hubbellc/Speaker/Speaker Assembly.jpg

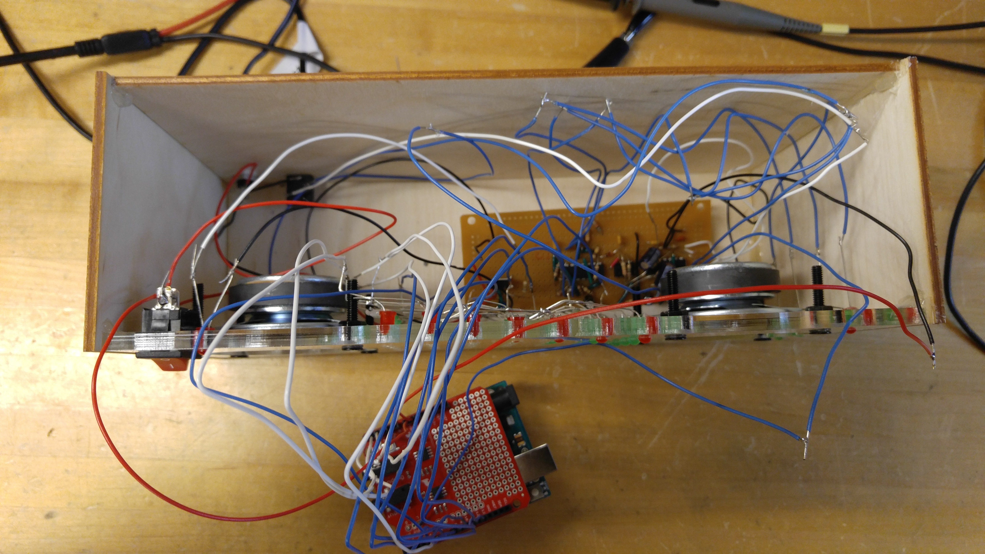
Speaker Assembly.jpg
