hubbellc/Speaker/Speaker Design Files/Speaker Box.SLDASM

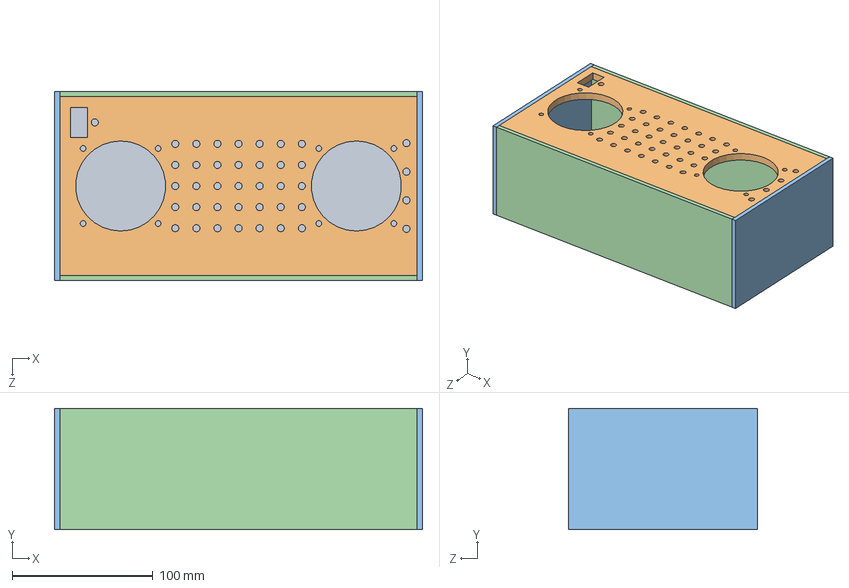
[picture p5: CAD file, 2018-04-09]
Speaker Design Files/Speaker Box.SLDASM
261.6 x 86.4 x 134.6 mm
Back plate
Side x 2
Top x 2
