hubbellc/Speaker/Speaker Design Files/DXF's/Front plate.SLDPRT.DXF

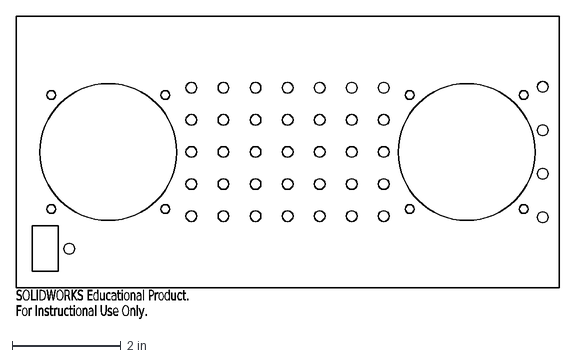
[picture p6: CAD file, 2018-04-09]
Speaker Design Files/DXF's/Front plate.SLDPRT.DXF
SOLIDWORKS Educational Product.
For Instructional Use Only.
