hubbellc/Speaker/Speaker Design Files/Top.SLDPRT

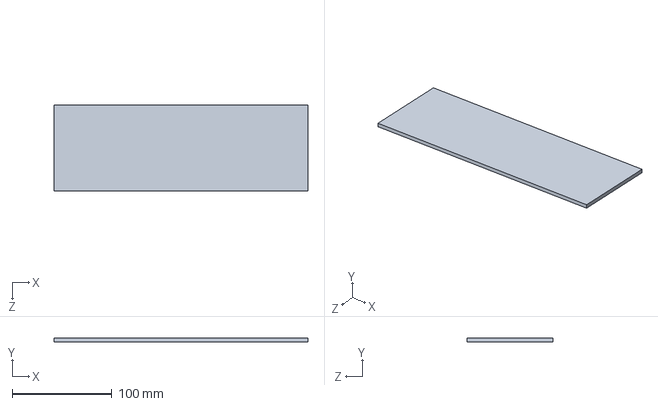
[picture p7: CAD file, 2018-04-09]
Speaker Design Files/Top.SLDPRT
254.0 x 3.81 x 86.4 mm
