hubbellc/Speaker/Speaker Design Files/Back plate.SLDPRT

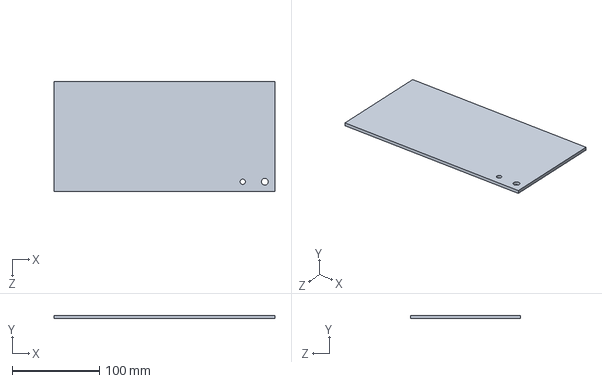
[picture p8: CAD file, 2018-04-09]
Speaker Design Files/Back plate.SLDPRT
254.0 x 3.81 x 127.0 mm
