hubbellc/Speaker/Speaker Design Files/DXF's/Back plate.DXF

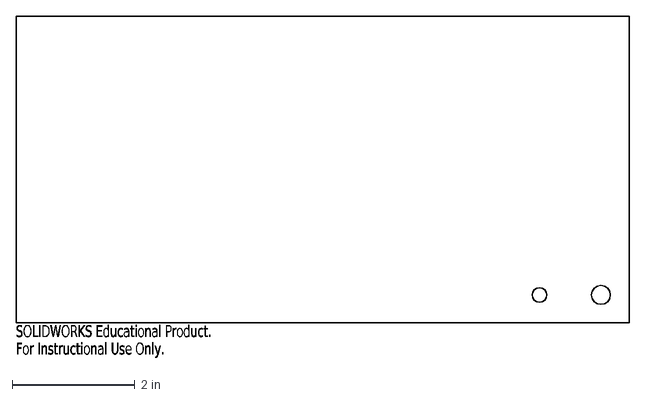
[picture p9: CAD file, 2018-04-09]
Speaker Design Files/DXF's/Back plate.DXF
SOLIDWORKS Educational Product.
For Instructional Use Only.
