hubbellc/Speaker/Speaker Design Files/DXF's/Side.DXF

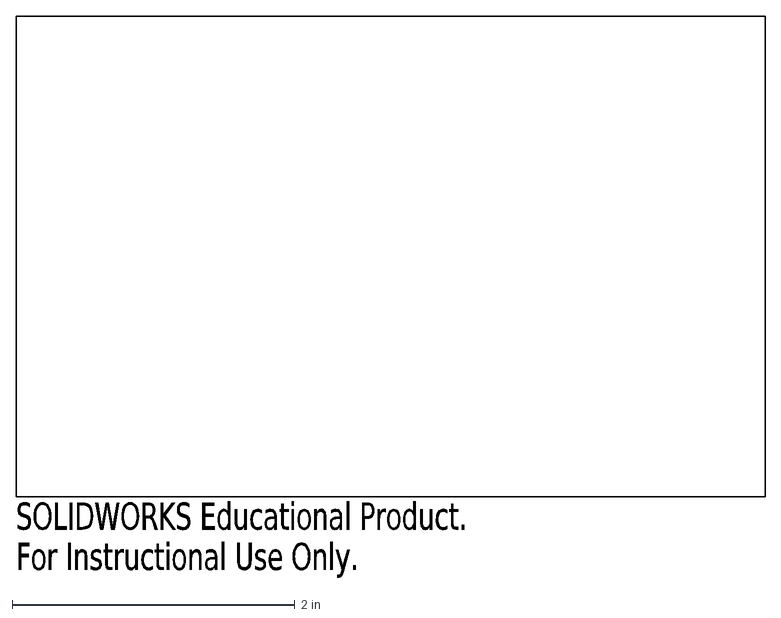
[picture p10: CAD file, 2018-04-09]
Speaker Design Files/DXF's/Side.DXF
SOLIDWORKS Educational Product.
For Instructional Use Only.
