hubbellc/Speaker/Speaker Design Files/DXF's/Top.DXF

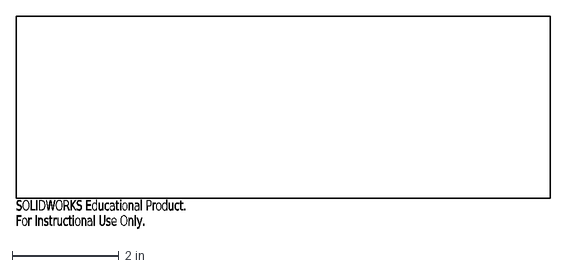
[picture p11: CAD file, 2018-04-09]
Speaker Design Files/DXF's/Top.DXF
SOLIDWORKS Educational Product.
For Instructional Use Only.
