hubbellc/Speaker/Speaker Design Files/Side.SLDPRT

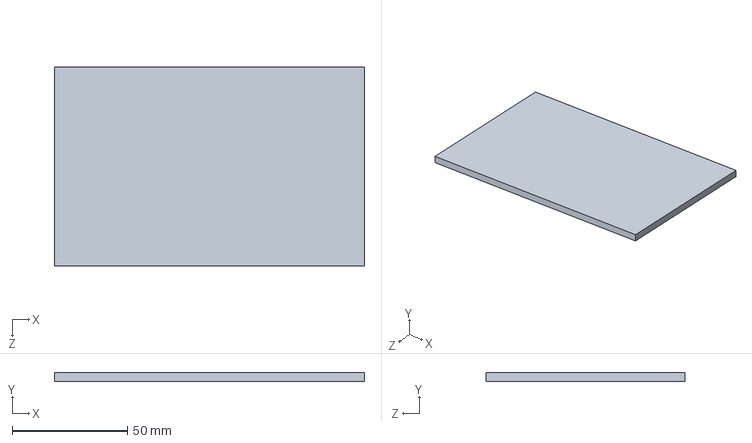
[picture p12: CAD file, 2018-04-09]
Speaker Design Files/Side.SLDPRT
134.6 x 3.81 x 86.4 mm
