hubbellc/Speaker/Speaker Design Files/Front plate.SLDPRT

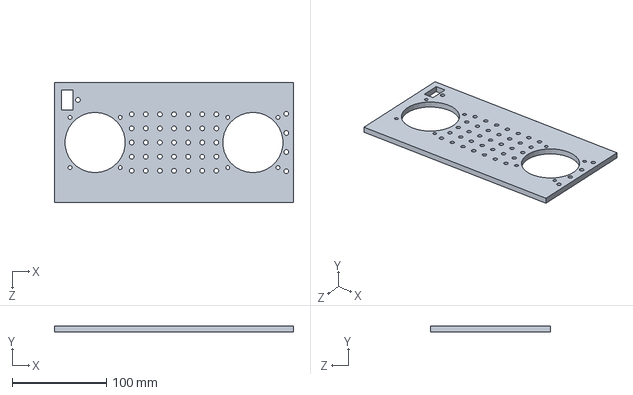
[picture p13: CAD file, 2018-04-09]
Speaker Design Files/Front plate.SLDPRT
254.0 x 6.35 x 127.0 mm
