hubbellc/Speaker/Speaker LED Array.pdf

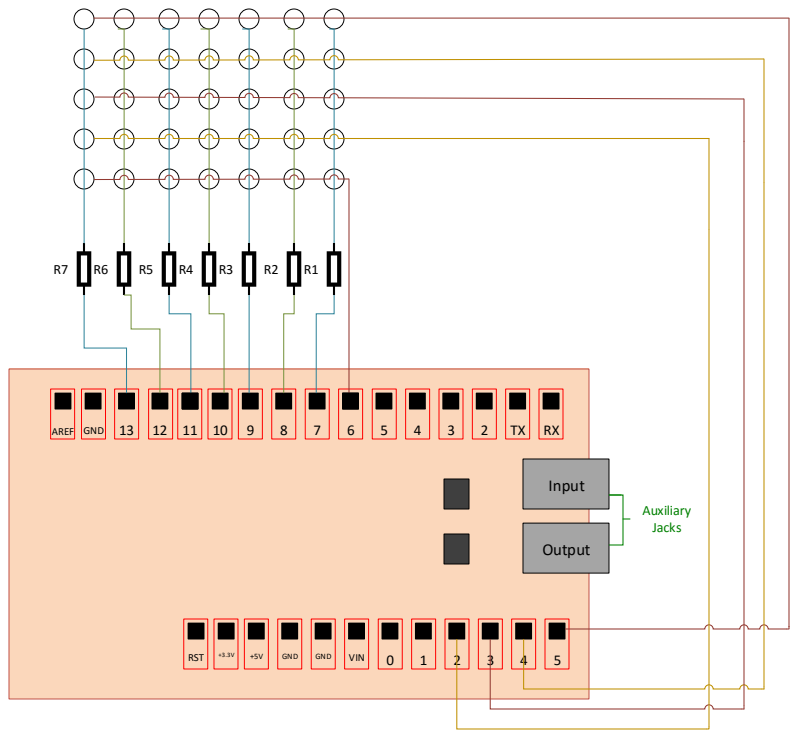
[picture p14: page 1]
AREF GND; VIN; 5 RST; GND; Input; Output; Auxiliary Jacks
