hubbellc/Speaker/(list of files, drawings)

Other design files:
Speaker Design Files/stereoamp2017.ms14
