hubbellc/Speaker/Speaker Arduino.jpg

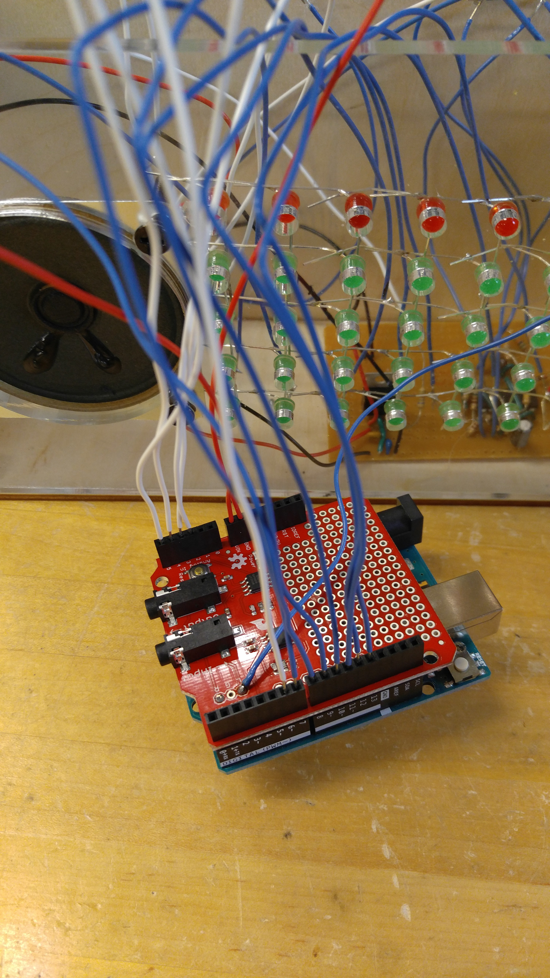
Speaker Arduino.jpg
