hubbellc/Speaker/Speaker Front.jpg

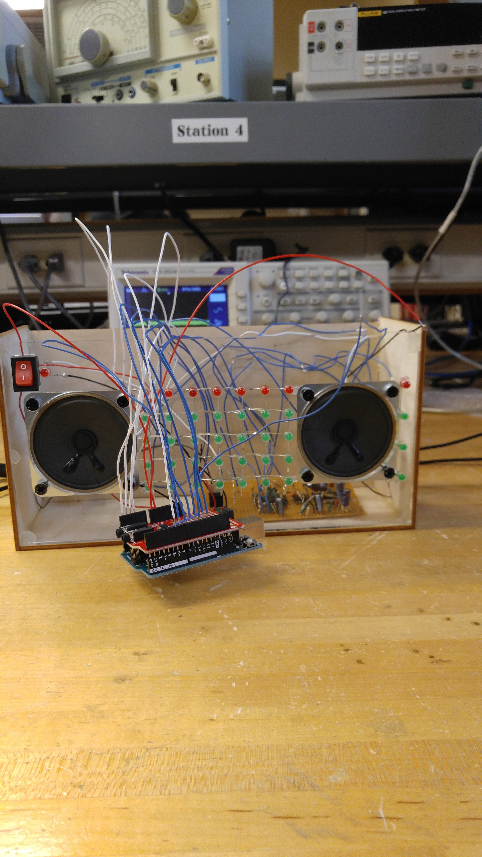
Speaker Front.jpg
